unixjazz/bigdot/(notices)

Notices in the files:
board/board.kicad_sch:
License: CERN OHL-S v2, see AUTHORS and LICENSE files for details
board-ext/wifi_shield.kicad_pcb:
[2021 CERN-OHL-S v.2]
